madpsy/xpa125b_controller/(threads)

Thread 1 (2023-03-11):

XPA125b_ controller + IC705

F1HCN, 2023-03-11:
Bonjour,
J'ai une erreur de compilation et je n'arrive pas a résoudre cette erreur:
 c:\Users\F1HCN\Documents\Arduino\libraries\SoftwareSerial\SoftwareSerial.cpp:41:10: fatal error: avr/interrupt.h: No such file or directory

Cordialement

Thread 4 (2023-11-28):

It gives errors when compiling.

Tetralogik, 2023-11-28:
Hello.
I am new to this. I have assembled all the circuits but when programming the D1 it gives me errors. The program does not compile and does not pass the verification.
Someone help me?
Thank you.

madpsy, 2023-12-06:
Hi, what errors is the compiler giving? It might be missing libraries.

Tetralogik, 2023-12-06:
Hello, good morning Madpsi.
Sorry for my English, I do it with a translator.
First of all, thank you for responding. I have been trying to solve it for more than a month but it is impossible. I have no knowledge. I already have the hardware installed but the software resists me.
First I had a library problem but by looking at the forums I was able to solve it.
But this problem I don't know what to do anymore.
I'm sending you a txt with the problems I'm having when compiling.
Thanks for everything.
A hug.

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

AVISO LEGAL: Este mensaje y sus archivos adjuntos van dirigidos exclusivamente a su destinatario, pudiendo contener información confidencial sometida a secreto profesional. No está permitida su comunicación, reproducción o distribución sin la autorización expresa de TETRALOGIK S.L.L.. Si usted no es el destinatario final, por favor elimínelo e infórmenos por esta vía.
PROTECCIÓN DE DATOS: De conformidad con lo dispuesto en el Reglamento (UE) 2016/679 de 27 de abril (GDPR) y la Ley Orgánica 3/2018 de 5 de diciembre (LOPDGDD), le informamos que los datos personales y dirección de correo electrónico del interesado, serán tratados bajo la responsabilidad de TETRALOGIK S.L.L. por un interés legítimo y para el envío de comunicaciones sobre nuestros productos y servicios y se conservarán mientras ninguna de las partes se oponga a ello. Los datos no serán comunicados a terceros, salvo obligación legal. Le informamos que puede ejercer los derechos de acceso, rectificación, portabilidad y supresión de sus datos y los de limitación y oposición a su tratamiento dirigiéndose a Andrés Isasi, 11 2 Módulo 2 - 48012 BILBAO (Bizkaia). Email: ***@***.*** ***@***.***>. Si considera que el tratamiento no se ajusta a la normativa vigente, podrá presentar una reclamación ante la autoridad de control en www.aepd.es <http://www.aepd.es/>.

This message and any attachments are intended exclusively for their destination and may contain confidential information subject to professional secrecy. Is not permitted their communication, reproduction or distribution without the express written permission of TETRALOGIK S.L.L.. If you are not the intended recipient, please delete and inform us by this route.According to the Regulation (EU) 2016/679 of 27 April 2016 (GDPR and 3/2018 Dec. 5 (LOPDGDD), we inform you that the personal information and email address, obtained from the data subject or of public sources, will be part of a file of TETRALOGIK S.L.L., with the finality of it send communications about our products and services and will be preserved while there is mutual interest to do so. The data will not be communicated to third parties, except for legal obligation. If you wish, you may exercise your rights of access, rectification, portability and delete data and limitation and opposition to their treatment by contacting the address Andrés Isasi, 11, 2 Módulo 2 48012 BILBAO (BIZKAIA). ***@***.*** ***@***.***>..
P

Antes de imprimir este e-mail, piense si es necesario hacerlo. El medio ambiente es cosa de todos.
Think twice before printing this e-mail. Environmental protection is in our hands.

Tetralogik, 2023-12-07:
Thanks a lot.I thank you already. I've been trying to solve it for a long time but it's impossible. I have no knowledge.Thank you very much and a hug.Contestación desde mi móvil.Jose Ángel Rivas / Servicio ***@***.*** / +34609230814Tetralogik. 944109232 Andres Isasi 11-2° Mod-2 48.012 Bilbao www.tetralogik.comAVISO LEGAL: Este mensaje y sus archivos adjuntos van dirigidos exclusivamente a su destinatario, pudiendo contener información confidencial sometida a secreto profesional. No está permitida su comunicación, reproducción o distribución sin la autorización expresa de TETRALOGIK S.L.L.. Si usted no es el destinatario final, por favor elimínelo e infórmenos por esta vía.PROTECCIÓN DE DATOS: De conformidad con lo dispuesto en el Reglamento (UE) 2016/679 de 27 de abril (GDPR) y la Ley Orgánica 3/2018 de 5 de diciembre (LOPDGDD), le informamos que los datos personales y dirección de correo electrónico del interesado, serán tratados bajo la responsabilidad de TETRALOGIK S.L.L. por un interés legítimo y para el envío de comunicaciones sobre nuestros productos y servicios y se conservarán mientras ninguna de las partes se oponga a ello. Los datos no serán comunicados a terceros, salvo obligación legal. Le informamos que puede ejercer los derechos de acceso, rectificación, portabilidad y supresión de sus datos y los de limitación y oposición a su tratamiento dirigiéndose a Andrés Isasi, 11 2 Módulo 2 - 48012 ***@***.*** Si considera que el tratamiento no se ajusta a la normativa vigente, podrá presentar una reclamación ante la autoridad de control en www.aepd.es.Antes de imprimir este e-mail, piense si es necesario hacerlo.Think twice before printing this e-mail. Environmental protection is in our hands.El 7 dic 2023, a las 13:24, madpsy ***@***.***> escribió:
I will try to compile it again myself this weekend. Haven't touched the code for a long time so interested to see what is wrong.

—Reply to this email directly, view it on GitHub, or unsubscribe.You are receiving this because you authored the thread.Message ID: ***@***.***>

Thread 5 (2023-12-06):

Error

Tetralogik, 2023-12-06:
[errores Comp.pdf](https://github.com/madpsy/xpa125b_controller/files/13590886/errores.Comp.pdf)

Tetralogik, 2024-01-04:
Hello.
Happy new year.
Any news with the errors?
A hug.

rwatkinsii, 2024-01-18:
I did manage to get it to compile and upload.

IDE Version: 1.8.18
ArduinoJSON Version: 6.21.1
Install the libraries provided in the project and it compiles without any errors.

madpsy, 2024-01-22:
Thanks and apologies for not answering. At least it compiles on an older version. I suspect a fair few sections need rewritten / fixed to be more compliant. Basically sloppy code.

Thread 7 (2024-01-17):

Compiler Errors

rwatkinsii, 2024-01-17:
Looking for assistance with getting your code compiled.  I don't think the warnings are preventing it from finishing and uploading just the two errors at the end. My email is kc3pgn@gmail.com and I am thankful for any assistance you can provide. I already have the hardware built and just need to get the code on the board.

C:\Users\K3RAW\Desktop\Amp\xpa125b_controller-main\d1mini_amp_controller_edited\d1mini_amp_controller_edited.ino: In function 'char* MAX3232serialRead(char)':
C:\Users\K3RAW\Desktop\Amp\xpa125b_controller-main\d1mini_amp_controller_edited\d1mini_amp_controller_edited.ino:329:1: error: control reaches end of non-void function [-Werror=return-type]
  329 | }
      | ^
C:\Users\K3RAW\Desktop\Amp\xpa125b_controller-main\d1mini_amp_controller_edited\d1mini_amp_controller_edited.ino: In function 'bool setupAmplifier(String)':
C:\Users\K3RAW\Desktop\Amp\xpa125b_controller-main\d1mini_amp_controller_edited\d1mini_amp_controller_edited.ino:451:1: error: control reaches end of non-void function [-Werror=return-type]
  451 | }
      | ^
cc1plus.exe: some warnings being treated as errors

madpsy, 2024-01-17:
There's someone else asking the same thing. This compiled last time I tried so I'm guessing something changed in how the Arduino IDE compiles, or rather it is stricter now.

`control reaches end of non-void function` that suggests I have sloppy functions which need an `else` or similar.

rwatkinsii, 2024-01-17:
I did manage to get it to compile and upload. I believe you are correct because to get it to compile I had to download an older version of IDE software, install your version of the plugins, and download 1 full version older of the only plugin not provided. Once I did this it worked flawless. If you would like to get screenshots of all the versions I can share it with you. Thank You,      Robert WatkinsOn Jan 17, 2024, at 4:06 AM, madpsy ***@***.***> wrote:
There's someone else asking the same thing. This compiled last time I tried so I'm guessing something changed in how the Arduino IDE compiles, or rather it is stricter now.
control reaches end of non-void function that suggests I have sloppy functions which need an else or similar.

—Reply to this email directly, view it on GitHub, or unsubscribe.You are receiving this because you authored the thread.Message ID: ***@***.***>

rwatkinsii, 2024-01-17:
Madpsy Do you know if I remove the Bluetooth module can I somehow send CIV data directly into the device via a wire? I purchased the VE2DX Device that connects to Bluetooth and gives 3 CIV outputs.

Tetralogik, 2024-01-18:
Hello.
No matter how hard I try, even with version 1.8.18, I can't get it.
It gives me a lot of errors.
I think I'm giving up.

rwatkinsii, 2024-01-18:
Dont give up! Did you make sure to use the library's that was provided in the zip file?

Tetralogik, 2024-01-18:
Okay.
No, I didn't do that.
Download them, do not use the ones that come in the zip.
I do not know how to do it?

Tetralogik, 2024-01-18:
I think i found it.
Add libraries to the menu from file.
But I still have the same errors.

Tetralogik, 2024-01-18:
Arduino:1.8.18 (Mac OS X), Tarjeta:"LOLIN(WEMOS) D1 mini (clone), 80 MHz, Flash, Disabled (new aborts on oom), Disabled, All SSL ciphers (most compatible), 32KB cache + 32KB IRAM (balanced), Use pgm_read macros for IRAM/PROGMEM, DOUT (compatible), 40MHz, 4MB (FS:2MB OTA:~1019KB), v2 Lower Memory, Disabled, None, Only Sketch, 921600"

/Users/joseangel/Downloads/xpa125b_controller-main/d1mini-amp-controller/d1mini-amp-controller.ino:16:20: warning: ISO C++ forbids converting a string constant to 'char*' [-Wwrite-strings]
   16 | char* ntp_server = "pool.ntp.org";
      |                    ^~~~~~~~~~~~~~
/Users/joseangel/Downloads/xpa125b_controller-main/d1mini-amp-controller/d1mini-amp-controller.ino:30:24: warning: ISO C++ forbids converting a string constant to 'char*' [-Wwrite-strings]
   30 | char* icom_interface = "hc_05";
      |                        ^~~~~~~
/Users/joseangel/Downloads/xpa125b_controller-main/d1mini-amp-controller/d1mini-amp-controller.ino: In function 'bool loadConfig()':
/Users/joseangel/Downloads/xpa125b_controller-main/d1mini-amp-controller/d1mini-amp-controller.ino:195:19: warning: ISO C++ forbids converting a string constant to 'char*' [-Wwrite-strings]
  195 |     serialPrintln("Failed to open config file");
      |                   ^~~~~~~~~~~~~~~~~~~~~~~~~~~~
/Users/joseangel/Downloads/xpa125b_controller-main/d1mini-amp-controller/d1mini-amp-controller.ino:201:19: warning: ISO C++ forbids converting a string constant to 'char*' [-Wwrite-strings]
  201 |     serialPrintln("Config file size is too large");
      |                   ^~~~~~~~~~~~~~~~~~~~~~~~~~~~~~~
/Users/joseangel/Downloads/xpa125b_controller-main/d1mini-amp-controller/d1mini-amp-controller.ino:212:19: warning: ISO C++ forbids converting a string constant to 'char*' [-Wwrite-strings]
  212 |     serialPrintln("Failed to parse config");
      |                   ^~~~~~~~~~~~~~~~~~~~~~~~
/Users/joseangel/Downloads/xpa125b_controller-main/d1mini-amp-controller/d1mini-amp-controller.ino: In function 'bool saveConfig()':
/Users/joseangel/Downloads/xpa125b_controller-main/d1mini-amp-controller/d1mini-amp-controller.ino:241:19: warning: ISO C++ forbids converting a string constant to 'char*' [-Wwrite-strings]
  241 |     serialPrintln("Failed to open config file for writing");
      |                   ^~~~~~~~~~~~~~~~~~~~~~~~~~~~~~~~~~~~~~~~
/Users/joseangel/Downloads/xpa125b_controller-main/d1mini-amp-controller/d1mini-amp-controller.ino: In function 'char* MAX3232serialRead(char)':
/Users/joseangel/Downloads/xpa125b_controller-main/d1mini-amp-controller/d1mini-amp-controller.ino:301:23: warning: ISO C++ forbids converting a string constant to 'char*' [-Wwrite-strings]
  301 |         serialPrintln("Serial timeout");
      |                       ^~~~~~~~~~~~~~~~
/Users/joseangel/Downloads/xpa125b_controller-main/d1mini-amp-controller/d1mini-amp-controller.ino:303:16: warning: ISO C++ forbids converting a string constant to 'char*' [-Wwrite-strings]
  303 |       return("");
      |                ^
/Users/joseangel/Downloads/xpa125b_controller-main/d1mini-amp-controller/d1mini-amp-controller.ino:324:23: warning: ISO C++ forbids converting a string constant to 'char*' [-Wwrite-strings]
  324 |         serialPrintln("");
      |                       ^~
/Users/joseangel/Downloads/xpa125b_controller-main/d1mini-amp-controller/d1mini-amp-controller.ino: In function 'void webServer(bool)':
/Users/joseangel/Downloads/xpa125b_controller-main/d1mini-amp-controller/d1mini-amp-controller.ino:352:19: warning: ISO C++ forbids converting a string constant to 'char*' [-Wwrite-strings]
  352 |     serialPrintln("HTTP server started");
      |                   ^~~~~~~~~~~~~~~~~~~~~
/Users/joseangel/Downloads/xpa125b_controller-main/d1mini-amp-controller/d1mini-amp-controller.ino:356:19: warning: ISO C++ forbids converting a string constant to 'char*' [-Wwrite-strings]
  356 |     serialPrintln("HTTP server stopped");
      |                   ^~~~~~~~~~~~~~~~~~~~~
/Users/joseangel/Downloads/xpa125b_controller-main/d1mini-amp-controller/d1mini-amp-controller.ino: In function 'void mqttConnect()':
/Users/joseangel/Downloads/xpa125b_controller-main/d1mini-amp-controller/d1mini-amp-controller.ino:368:19: warning: ISO C++ forbids converting a string constant to 'char*' [-Wwrite-strings]
  368 |     serialPrintln("Attempting MQTT connection");
      |                   ^~~~~~~~~~~~~~~~~~~~~~~~~~~~
/Users/joseangel/Downloads/xpa125b_controller-main/d1mini-amp-controller/d1mini-amp-controller.ino:371:21: warning: ISO C++ forbids converting a string constant to 'char*' [-Wwrite-strings]
  371 |       serialPrintln("MQTT connected");
      |                     ^~~~~~~~~~~~~~~~
/Users/joseangel/Downloads/xpa125b_controller-main/d1mini-amp-controller/d1mini-amp-controller.ino: In function 'bool setupBandData()':
/Users/joseangel/Downloads/xpa125b_controller-main/d1mini-amp-controller/d1mini-amp-controller.ino:399:19: warning: ISO C++ forbids converting a string constant to 'char*' [-Wwrite-strings]
  399 |     serialPrintln("Band data pins configured");
      |                   ^~~~~~~~~~~~~~~~~~~~~~~~~~~
/Users/joseangel/Downloads/xpa125b_controller-main/d1mini-amp-controller/d1mini-amp-controller.ino:403:19: warning: ISO C++ forbids converting a string constant to 'char*' [-Wwrite-strings]
  403 |     serialPrintln("Cannot setup band data when any other serial based device is enabled");
      |                   ^~~~~~~~~~~~~~~~~~~~~~~~~~~~~~~~~~~~~~~~~~~~~~~~~~~~~~~~~~~~~~~~~~~~~~
/Users/joseangel/Downloads/xpa125b_controller-main/d1mini-amp-controller/d1mini-amp-controller.ino: In function 'bool setupMAX3232()':
/Users/joseangel/Downloads/xpa125b_controller-main/d1mini-amp-controller/d1mini-amp-controller.ino:413:19: warning: ISO C++ forbids converting a string constant to 'char*' [-Wwrite-strings]
  413 |       serialPrint("MAX3232 configured at baudrate ");
      |                   ^~~~~~~~~~~~~~~~~~~~~~~~~~~~~~~~~
/Users/joseangel/Downloads/xpa125b_controller-main/d1mini-amp-controller/d1mini-amp-controller.ino:418:21: warning: ISO C++ forbids converting a string constant to 'char*' [-Wwrite-strings]
  418 |       serialPrintln("You must set max3232_enabled to true");
      |                     ^~~~~~~~~~~~~~~~~~~~~~~~~~~~~~~~~~~~~~
/Users/joseangel/Downloads/xpa125b_controller-main/d1mini-amp-controller/d1mini-amp-controller.ino:423:19: warning: ISO C++ forbids converting a string constant to 'char*' [-Wwrite-strings]
  423 |     serialPrintln("Cannot setup MAX3232 when Hermes is enabled");
      |                   ^~~~~~~~~~~~~~~~~~~~~~~~~~~~~~~~~~~~~~~~~~~~~
/Users/joseangel/Downloads/xpa125b_controller-main/d1mini-amp-controller/d1mini-amp-controller.ino: In function 'bool setupAmplifier(String)':
/Users/joseangel/Downloads/xpa125b_controller-main/d1mini-amp-controller/d1mini-amp-controller.ino:432:19: warning: ISO C++ forbids converting a string constant to 'char*' [-Wwrite-strings]
  432 |     serialPrintln("Amplifier set to xpa125b");
      |                   ^~~~~~~~~~~~~~~~~~~~~~~~~~
/Users/joseangel/Downloads/xpa125b_controller-main/d1mini-amp-controller/d1mini-amp-controller.ino:437:19: warning: ISO C++ forbids converting a string constant to 'char*' [-Wwrite-strings]
  437 |     serialPrintln("Amplifier set to xpa125b");
      |                   ^~~~~~~~~~~~~~~~~~~~~~~~~~
/Users/joseangel/Downloads/xpa125b_controller-main/d1mini-amp-controller/d1mini-amp-controller.ino:443:21: warning: ISO C++ forbids converting a string constant to 'char*' [-Wwrite-strings]
  443 |       serialPrintln("Amplifier set to hardrock50");
      |                     ^~~~~~~~~~~~~~~~~~~~~~~~~~~~~
/Users/joseangel/Downloads/xpa125b_controller-main/d1mini-amp-controller/d1mini-amp-controller.ino:448:21: warning: ISO C++ forbids converting a string constant to 'char*' [-Wwrite-strings]
  448 |       serialPrintln("Failed to set amplifier set to hardrock50");
      |                     ^~~~~~~~~~~~~~~~~~~~~~~~~~~~~~~~~~~~~~~~~~~
/Users/joseangel/Downloads/xpa125b_controller-main/d1mini-amp-controller/d1mini-amp-controller.ino: In function 'bool setupHermes()':
/Users/joseangel/Downloads/xpa125b_controller-main/d1mini-amp-controller/d1mini-amp-controller.ino:458:19: warning: ISO C++ forbids converting a string constant to 'char*' [-Wwrite-strings]
  458 |     serialPrintln("Hermes-Lite configured");
      |                   ^~~~~~~~~~~~~~~~~~~~~~~~
/Users/joseangel/Downloads/xpa125b_controller-main/d1mini-amp-controller/d1mini-amp-controller.ino:462:19: warning: ISO C++ forbids converting a string constant to 'char*' [-Wwrite-strings]
  462 |     serialPrintln("Error: Hermes is not enabled and/or max3232 is enabled");
      |                   ^~~~~~~~~~~~~~~~~~~~~~~~~~~~~~~~~~~~~~~~~~~~~~~~~~~~~~~~
/Users/joseangel/Downloads/xpa125b_controller-main/d1mini-amp-controller/d1mini-amp-controller.ino: In function 'void setRigctlAddress(String)':
/Users/joseangel/Downloads/xpa125b_controller-main/d1mini-amp-controller/d1mini-amp-controller.ino:530:15: warning: ISO C++ forbids converting a string constant to 'char*' [-Wwrite-strings]
  530 |   serialPrint("rigctl_address ");
      |               ^~~~~~~~~~~~~~~~~
/Users/joseangel/Downloads/xpa125b_controller-main/d1mini-amp-controller/d1mini-amp-controller.ino: In function 'void setRigctlPort(String)':
/Users/joseangel/Downloads/xpa125b_controller-main/d1mini-amp-controller/d1mini-amp-controller.ino:539:15: warning: ISO C++ forbids converting a string constant to 'char*' [-Wwrite-strings]
  539 |   serialPrint("rigctl_port ");
      |               ^~~~~~~~~~~~~~
/Users/joseangel/Downloads/xpa125b_controller-main/d1mini-amp-controller/d1mini-amp-controller.ino: In function 'bool testRigctlServer()':
/Users/joseangel/Downloads/xpa125b_controller-main/d1mini-amp-controller/d1mini-amp-controller.ino:546:28: warning: ISO C++ forbids converting a string constant to 'char*' [-Wwrite-strings]
  546 |     if ((sendRigctlCommand("t") == "0") || (sendRigctlCommand("t") == "1")) {
      |                            ^~~
/Users/joseangel/Downloads/xpa125b_controller-main/d1mini-amp-controller/d1mini-amp-controller.ino:546:63: warning: ISO C++ forbids converting a string constant to 'char*' [-Wwrite-strings]
  546 |     if ((sendRigctlCommand("t") == "0") || (sendRigctlCommand("t") == "1")) {
      |                                                               ^~~
/Users/joseangel/Downloads/xpa125b_controller-main/d1mini-amp-controller/d1mini-amp-controller.ino:548:19: warning: ISO C++ forbids converting a string constant to 'char*' [-Wwrite-strings]
  548 |       serialPrint("Connection to rigctl server succeeded ");
      |                   ^~~~~~~~~~~~~~~~~~~~~~~~~~~~~~~~~~~~~~~~
/Users/joseangel/Downloads/xpa125b_controller-main/d1mini-amp-controller/d1mini-amp-controller.ino:553:19: warning: ISO C++ forbids converting a string constant to 'char*' [-Wwrite-strings]
  553 |       serialPrint("connection to rigctl succeeded but PTT status failed to return ");
      |                   ^~~~~~~~~~~~~~~~~~~~~~~~~~~~~~~~~~~~~~~~~~~~~~~~~~~~~~~~~~~~~~~~~
/Users/joseangel/Downloads/xpa125b_controller-main/d1mini-amp-controller/d1mini-amp-controller.ino:563:17: warning: ISO C++ forbids converting a string constant to 'char*' [-Wwrite-strings]
  563 |     serialPrint("connection to rigctl server failed ");
      |                 ^~~~~~~~~~~~~~~~~~~~~~~~~~~~~~~~~~~~~
/Users/joseangel/Downloads/xpa125b_controller-main/d1mini-amp-controller/d1mini-amp-controller.ino:572:19: warning: ISO C++ forbids converting a string constant to 'char*' [-Wwrite-strings]
  572 |     serialPrintln("rigctl server not set");
      |                   ^~~~~~~~~~~~~~~~~~~~~~~
/Users/joseangel/Downloads/xpa125b_controller-main/d1mini-amp-controller/d1mini-amp-controller.ino: In function 'bool connectRigctl()':
/Users/joseangel/Downloads/xpa125b_controller-main/d1mini-amp-controller/d1mini-amp-controller.ino:583:23: warning: ISO C++ forbids converting a string constant to 'char*' [-Wwrite-strings]
  583 |         serialPrintln("rigctl connection success");
      |                       ^~~~~~~~~~~~~~~~~~~~~~~~~~~
/Users/joseangel/Downloads/xpa125b_controller-main/d1mini-amp-controller/d1mini-amp-controller.ino:588:21: warning: ISO C++ forbids converting a string constant to 'char*' [-Wwrite-strings]
  588 |       serialPrintln("rigctl connection failed");
      |                     ^~~~~~~~~~~~~~~~~~~~~~~~~~
/Users/joseangel/Downloads/xpa125b_controller-main/d1mini-amp-controller/d1mini-amp-controller.ino:593:19: warning: ISO C++ forbids converting a string constant to 'char*' [-Wwrite-strings]
  593 |     serialPrintln("wifi disabled or rigctl address and port not set");
      |                   ^~~~~~~~~~~~~~~~~~~~~~~~~~~~~~~~~~~~~~~~~~~~~~~~~~
/Users/joseangel/Downloads/xpa125b_controller-main/d1mini-amp-controller/d1mini-amp-controller.ino: In function 'String sendRigctlCommand(char*)':
/Users/joseangel/Downloads/xpa125b_controller-main/d1mini-amp-controller/d1mini-amp-controller.ino:614:27: warning: ISO C++ forbids converting a string constant to 'char*' [-Wwrite-strings]
  614 |             serialPrintln("rigctl timed out");
      |                           ^~~~~~~~~~~~~~~~~~
/Users/joseangel/Downloads/xpa125b_controller-main/d1mini-amp-controller/d1mini-amp-controller.ino: In function 'void setRigctlFreq(String)':
/Users/joseangel/Downloads/xpa125b_controller-main/d1mini-amp-controller/d1mini-amp-controller.ino:645:18: warning: ISO C++ forbids converting a string constant to 'char*' [-Wwrite-strings]
  645 |      serialPrint("rigctlfreq: ");
      |                  ^~~~~~~~~~~~~~
/Users/joseangel/Downloads/xpa125b_controller-main/d1mini-amp-controller/d1mini-amp-controller.ino: In function 'void setRigMode(String)':
/Users/joseangel/Downloads/xpa125b_controller-main/d1mini-amp-controller/d1mini-amp-controller.ino:665:20: warning: ISO C++ forbids converting a string constant to 'char*' [-Wwrite-strings]
  665 |        serialPrint("rigmode ");
      |                    ^~~~~~~~~~
/Users/joseangel/Downloads/xpa125b_controller-main/d1mini-amp-controller/d1mini-amp-controller.ino: In function 'void setHybrid(String)':
/Users/joseangel/Downloads/xpa125b_controller-main/d1mini-amp-controller/d1mini-amp-controller.ino:692:19: warning: ISO C++ forbids converting a string constant to 'char*' [-Wwrite-strings]
  692 |     serialPrintln("hybrid true");
      |                   ^~~~~~~~~~~~~
/Users/joseangel/Downloads/xpa125b_controller-main/d1mini-amp-controller/d1mini-amp-controller.ino:696:19: warning: ISO C++ forbids converting a string constant to 'char*' [-Wwrite-strings]
  696 |     serialPrintln("hybrid false");
      |                   ^~~~~~~~~~~~~~
/Users/joseangel/Downloads/xpa125b_controller-main/d1mini-amp-controller/d1mini-amp-controller.ino: In function 'void setRigctlPtt(String)':
/Users/joseangel/Downloads/xpa125b_controller-main/d1mini-amp-controller/d1mini-amp-controller.ino:704:20: warning: ISO C++ forbids converting a string constant to 'char*' [-Wwrite-strings]
  704 |      serialPrintln("Cannot send rigctl PTT event as TX is blocked");
      |                    ^~~~~~~~~~~~~~~~~~~~~~~~~~~~~~~~~~~~~~~~~~~~~~~
/Users/joseangel/Downloads/xpa125b_controller-main/d1mini-amp-controller/d1mini-amp-controller.ino:708:18: warning: ISO C++ forbids converting a string constant to 'char*' [-Wwrite-strings]
  708 |      serialPrint("rigctlptt: ");
      |                  ^~~~~~~~~~~~~
/Users/joseangel/Downloads/xpa125b_controller-main/d1mini-amp-controller/d1mini-amp-controller.ino: In function 'void setMode(String)':
/Users/joseangel/Downloads/xpa125b_controller-main/d1mini-amp-controller/d1mini-amp-controller.ino:969:17: warning: ISO C++ forbids converting a string constant to 'char*' [-Wwrite-strings]
  969 |     serialPrint("mode ");
      |                 ^~~~~~~
/Users/joseangel/Downloads/xpa125b_controller-main/d1mini-amp-controller/d1mini-amp-controller.ino:973:21: warning: ISO C++ forbids converting a string constant to 'char*' [-Wwrite-strings]
  973 |       serialPrintln("hybrid mode for PTT is enabled");
      |                     ^~~~~~~~~~~~~~~~~~~~~~~~~~~~~~~~
/Users/joseangel/Downloads/xpa125b_controller-main/d1mini-amp-controller/d1mini-amp-controller.ino: In function 'void setBand(String)':
/Users/joseangel/Downloads/xpa125b_controller-main/d1mini-amp-controller/d1mini-amp-controller.ino:1093:19: warning: ISO C++ forbids converting a string constant to 'char*' [-Wwrite-strings]
 1093 |       serialPrint("band ");
      |                   ^~~~~~~
/Users/joseangel/Downloads/xpa125b_controller-main/d1mini-amp-controller/d1mini-amp-controller.ino: In function 'void setFreq(String)':
/Users/joseangel/Downloads/xpa125b_controller-main/d1mini-amp-controller/d1mini-amp-controller.ino:1161:16: warning: ISO C++ forbids converting a string constant to 'char*' [-Wwrite-strings]
 1161 |    serialPrint("frequency ");
      |                ^~~~~~~~~~~~
/Users/joseangel/Downloads/xpa125b_controller-main/d1mini-amp-controller/d1mini-amp-controller.ino:1163:29: warning: ISO C++ forbids converting a string constant to 'char*' [-Wwrite-strings]
 1163 |    if (regexMatch(charFreq, "^1......$")) {
      |                             ^~~~~~~~~~~
/Users/joseangel/Downloads/xpa125b_controller-main/d1mini-amp-controller/d1mini-amp-controller.ino:1165:36: warning: ISO C++ forbids converting a string constant to 'char*' [-Wwrite-strings]
 1165 |    } else if (regexMatch(charFreq, "^3......$")) {
      |                                    ^~~~~~~~~~~
/Users/joseangel/Downloads/xpa125b_controller-main/d1mini-amp-controller/d1mini-amp-controller.ino:1167:36: warning: ISO C++ forbids converting a string constant to 'char*' [-Wwrite-strings]
 1167 |    } else if (regexMatch(charFreq, "^3......$")) {
      |                                    ^~~~~~~~~~~
/Users/joseangel/Downloads/xpa125b_controller-main/d1mini-amp-controller/d1mini-amp-controller.ino:1169:36: warning: ISO C++ forbids converting a string constant to 'char*' [-Wwrite-strings]
 1169 |    } else if (regexMatch(charFreq, "^5......$")) {
      |                                    ^~~~~~~~~~~
/Users/joseangel/Downloads/xpa125b_controller-main/d1mini-amp-controller/d1mini-amp-controller.ino:1171:36: warning: ISO C++ forbids converting a string constant to 'char*' [-Wwrite-strings]
 1171 |    } else if (regexMatch(charFreq, "^7......$")) {
      |                                    ^~~~~~~~~~~
/Users/joseangel/Downloads/xpa125b_controller-main/d1mini-amp-controller/d1mini-amp-controller.ino:1173:36: warning: ISO C++ forbids converting a string constant to 'char*' [-Wwrite-strings]
 1173 |    } else if (regexMatch(charFreq, "^10......$")) {
      |                                    ^~~~~~~~~~~~
/Users/joseangel/Downloads/xpa125b_controller-main/d1mini-amp-controller/d1mini-amp-controller.ino:1175:36: warning: ISO C++ forbids converting a string constant to 'char*' [-Wwrite-strings]
 1175 |    } else if (regexMatch(charFreq, "^14......$")) {
      |                                    ^~~~~~~~~~~~
/Users/joseangel/Downloads/xpa125b_controller-main/d1mini-amp-controller/d1mini-amp-controller.ino:1177:36: warning: ISO C++ forbids converting a string constant to 'char*' [-Wwrite-strings]
 1177 |    } else if (regexMatch(charFreq, "^18......$")) {
      |                                    ^~~~~~~~~~~~
/Users/joseangel/Downloads/xpa125b_controller-main/d1mini-amp-controller/d1mini-amp-controller.ino:1179:36: warning: ISO C++ forbids converting a string constant to 'char*' [-Wwrite-strings]
 1179 |    } else if (regexMatch(charFreq, "^21......$")) {
      |                                    ^~~~~~~~~~~~
/Users/joseangel/Downloads/xpa125b_controller-main/d1mini-amp-controller/d1mini-amp-controller.ino:1181:36: warning: ISO C++ forbids converting a string constant to 'char*' [-Wwrite-strings]
 1181 |    } else if (regexMatch(charFreq, "^24......$")) {
      |                                    ^~~~~~~~~~~~
/Users/joseangel/Downloads/xpa125b_controller-main/d1mini-amp-controller/d1mini-amp-controller.ino:1183:36: warning: ISO C++ forbids converting a string constant to 'char*' [-Wwrite-strings]
 1183 |    } else if (regexMatch(charFreq, "^27......$")) {
      |                                    ^~~~~~~~~~~~
/Users/joseangel/Downloads/xpa125b_controller-main/d1mini-amp-controller/d1mini-amp-controller.ino:1185:36: warning: ISO C++ forbids converting a string constant to 'char*' [-Wwrite-strings]
 1185 |    } else if (regexMatch(charFreq, "^2[8,9]......$")) {
      |                                    ^~~~~~~~~~~~~~~~
/Users/joseangel/Downloads/xpa125b_controller-main/d1mini-amp-controller/d1mini-amp-controller.ino:1187:36: warning: ISO C++ forbids converting a string constant to 'char*' [-Wwrite-strings]
 1187 |    } else if (regexMatch(charFreq, "^5.......$")) {
      |                                    ^~~~~~~~~~~~
/Users/joseangel/Downloads/xpa125b_controller-main/d1mini-amp-controller/d1mini-amp-controller.ino:1191:17: warning: ISO C++ forbids converting a string constant to 'char*' [-Wwrite-strings]
 1191 |     serialPrint("No matching band found for ");
      |                 ^~~~~~~~~~~~~~~~~~~~~~~~~~~~~
/Users/joseangel/Downloads/xpa125b_controller-main/d1mini-amp-controller/d1mini-amp-controller.ino: In function 'void setState(String)':
/Users/joseangel/Downloads/xpa125b_controller-main/d1mini-amp-controller/d1mini-amp-controller.ino:1208:22: warning: ISO C++ forbids converting a string constant to 'char*' [-Wwrite-strings]
 1208 |        serialPrintln("state rx");
      |                      ^~~~~~~~~~
/Users/joseangel/Downloads/xpa125b_controller-main/d1mini-amp-controller/d1mini-amp-controller.ino:1222:25: warning: ISO C++ forbids converting a string constant to 'char*' [-Wwrite-strings]
 1222 |           serialPrintln("state tx");
      |                         ^~~~~~~~~~
/Users/joseangel/Downloads/xpa125b_controller-main/d1mini-amp-controller/d1mini-amp-controller.ino:1228:21: warning: ISO C++ forbids converting a string constant to 'char*' [-Wwrite-strings]
 1228 |       serialPrintln("TX blocked as band is not set");
      |                     ^~~~~~~~~~~~~~~~~~~~~~~~~~~~~~~
/Users/joseangel/Downloads/xpa125b_controller-main/d1mini-amp-controller/d1mini-amp-controller.ino: In function 'void setMQTT(String)':
/Users/joseangel/Downloads/xpa125b_controller-main/d1mini-amp-controller/d1mini-amp-controller.ino:1240:19: warning: ISO C++ forbids converting a string constant to 'char*' [-Wwrite-strings]
 1240 |     serialPrintln("MQTT enabled");
      |                   ^~~~~~~~~~~~~~
/Users/joseangel/Downloads/xpa125b_controller-main/d1mini-amp-controller/d1mini-amp-controller.ino:1245:19: warning: ISO C++ forbids converting a string constant to 'char*' [-Wwrite-strings]
 1245 |     serialPrintln("MQTT disabled");
      |                   ^~~~~~~~~~~~~~~
/Users/joseangel/Downloads/xpa125b_controller-main/d1mini-amp-controller/d1mini-amp-controller.ino: In function 'void wifi(String)':
/Users/joseangel/Downloads/xpa125b_controller-main/d1mini-amp-controller/d1mini-amp-controller.ino:1283:19: warning: ISO C++ forbids converting a string constant to 'char*' [-Wwrite-strings]
 1283 |       serialPrint(".");
      |                   ^~~
/Users/joseangel/Downloads/xpa125b_controller-main/d1mini-amp-controller/d1mini-amp-controller.ino:1287:21: warning: ISO C++ forbids converting a string constant to 'char*' [-Wwrite-strings]
 1287 |       serialPrintln("");
      |                     ^~
/Users/joseangel/Downloads/xpa125b_controller-main/d1mini-amp-controller/d1mini-amp-controller.ino:1289:19: warning: ISO C++ forbids converting a string constant to 'char*' [-Wwrite-strings]
 1289 |       serialPrint("Connected to ");
      |                   ^~~~~~~~~~~~~~~
/Users/joseangel/Downloads/xpa125b_controller-main/d1mini-amp-controller/d1mini-amp-controller.ino:1292:19: warning: ISO C++ forbids converting a string constant to 'char*' [-Wwrite-strings]
 1292 |       serialPrint("RSSI ");
      |                   ^~~~~~~
/Users/joseangel/Downloads/xpa125b_controller-main/d1mini-amp-controller/d1mini-amp-controller.ino:1295:19: warning: ISO C++ forbids converting a string constant to 'char*' [-Wwrite-strings]
 1295 |       serialPrint("IP address: ");
      |                   ^~~~~~~~~~~~~~
/Users/joseangel/Downloads/xpa125b_controller-main/d1mini-amp-controller/d1mini-amp-controller.ino:1298:19: warning: ISO C++ forbids converting a string constant to 'char*' [-Wwrite-strings]
 1298 |       serialPrint("DNS address: ");
      |                   ^~~~~~~~~~~~~~~
/Users/joseangel/Downloads/xpa125b_controller-main/d1mini-amp-controller/d1mini-amp-controller.ino:1301:19: warning: ISO C++ forbids converting a string constant to 'char*' [-Wwrite-strings]
 1301 |       serialPrint("Gateway: ");
      |                   ^~~~~~~~~~~
/Users/joseangel/Downloads/xpa125b_controller-main/d1mini-amp-controller/d1mini-amp-controller.ino:1304:19: warning: ISO C++ forbids converting a string constant to 'char*' [-Wwrite-strings]
 1304 |       serialPrint("MAC address: ");
      |                   ^~~~~~~~~~~~~~~
/Users/joseangel/Downloads/xpa125b_controller-main/d1mini-amp-controller/d1mini-amp-controller.ino:1308:23: warning: ISO C++ forbids converting a string constant to 'char*' [-Wwrite-strings]
 1308 |         serialPrintln("MDNS responder started as xpa125b[.local]");
      |                       ^~~~~~~~~~~~~~~~~~~~~~~~~~~~~~~~~~~~~~~~~~~
/Users/joseangel/Downloads/xpa125b_controller-main/d1mini-amp-controller/d1mini-amp-controller.ino:1312:21: warning: ISO C++ forbids converting a string constant to 'char*' [-Wwrite-strings]
 1312 |       serialPrintln("NTP client started");
      |                     ^~~~~~~~~~~~~~~~~~~~
/Users/joseangel/Downloads/xpa125b_controller-main/d1mini-amp-controller/d1mini-amp-controller.ino:1315:21: warning: ISO C++ forbids converting a string constant to 'char*' [-Wwrite-strings]
 1315 |       serialPrintln("");
      |                     ^~
/Users/joseangel/Downloads/xpa125b_controller-main/d1mini-amp-controller/d1mini-amp-controller.ino:1317:21: warning: ISO C++ forbids converting a string constant to 'char*' [-Wwrite-strings]
 1317 |       serialPrintln("WiFi failed to connect");
      |                     ^~~~~~~~~~~~~~~~~~~~~~~~
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

Thread 8 (2024-01-20):

RC Filter

rwatkinsii, 2024-01-20:
Your schematic says to use a 470uf ceramic capacitor, but the image looks like a 470pf cap. If it is a 470uF ceramic capacitor, where did you get it from?

madpsy, 2024-01-22:
It's been so long I don't remember - it's just used to try and smooth the output so try what you have in your parts drawer and see what happens. If band selection is stable then I'd call it a success.
